LionheadGuy/bench-box-v2/wiring/bench-box-v2-poster.pdf

# BENCH BOX V2 — POWER & CONNECTIONS

The battery box for the infotainment H5: what powers what, and what plugs into what.
NOT YET BUILT OR TESTED: test each custom board on a current-limited bench supply, without the pack, before it goes in a box.

### POWER

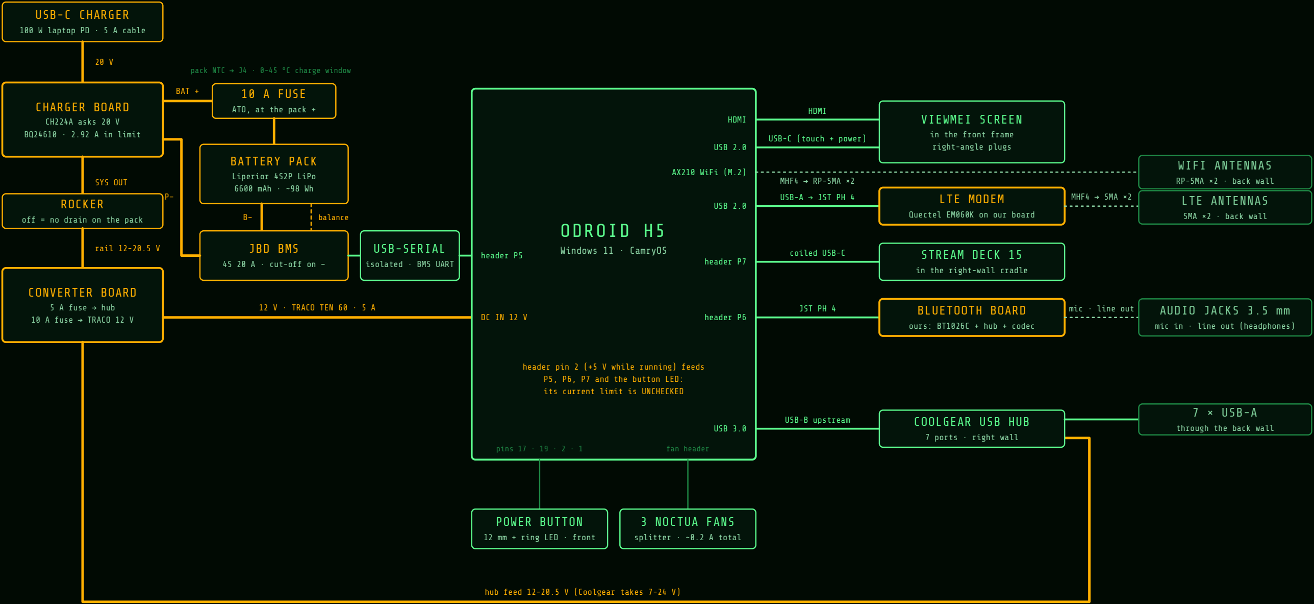
[picture p6: figure]
USB-C CHARGER; 100 W laptop PD · 5 A cable; CHARGER BOARD; CH224A asks 20 V BQ24610 · 2.92 A in limit; pack NTC → J4 · 0-45 °C charge window; BAT +; 10 A FUSE; ATO, at the pack +; BATTERY PACK; Liperior 4S2P LiPo 6600 mAh · ~98 Wh; balance; JBD BMS; 4S 20 A · cut-off on −; USB-SERIAL; isolated · BMS UART; SYS OUT ROCKER; off = no drain on the pack; rail 12-20.5 V; CONVERTER BOARD; 5 A fuse → hub 10 A fuse → TRACO 12 V; 12 V · TRACO TEN 60 · 5 A; ODROID H5; Windows 11 · CamryOS; header pin 2 (+5 V while running) feeds P5, P6, P7 and the button LED: its current limit is UNCHECKED; HDMI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

hub feed 12-20.5 V (Coolgear takes 7-24 V)

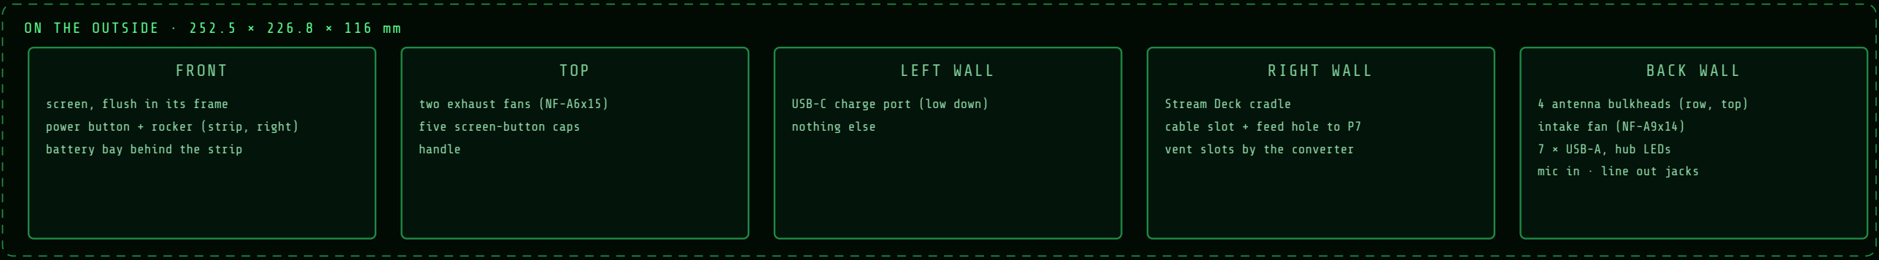
[picture p7: figure]
ON THE OUTSIDE · 252.5 × 226.8 × 116 mm; FRONT; screen, flush in its frame; power button + rocker (strip, right); battery bay behind the strip; TOP; two exhaust fans (NF-A6x15); five screen-button caps; handle; LEFT WALL; USB-C charge port (low down); nothing else; RIGHT WALL; Stream Deck cradle; cable slot + feed hole to P7; vent slots by the converter; BACK WALL; 4 antenna bulkheads (row, top); intake fan (NF-A9x14); 7 × USB-A, hub LEDs; mic in · line out jacks

power | USB / HDMI | antenna / audio lead | header pins / fan header | our own board | on the outside

Bench Box V2 · wire by wire: P.svg, D.svg, C.svg
