LionheadGuy/bench-box-v2/wiring/bench-box-v2-poster.png

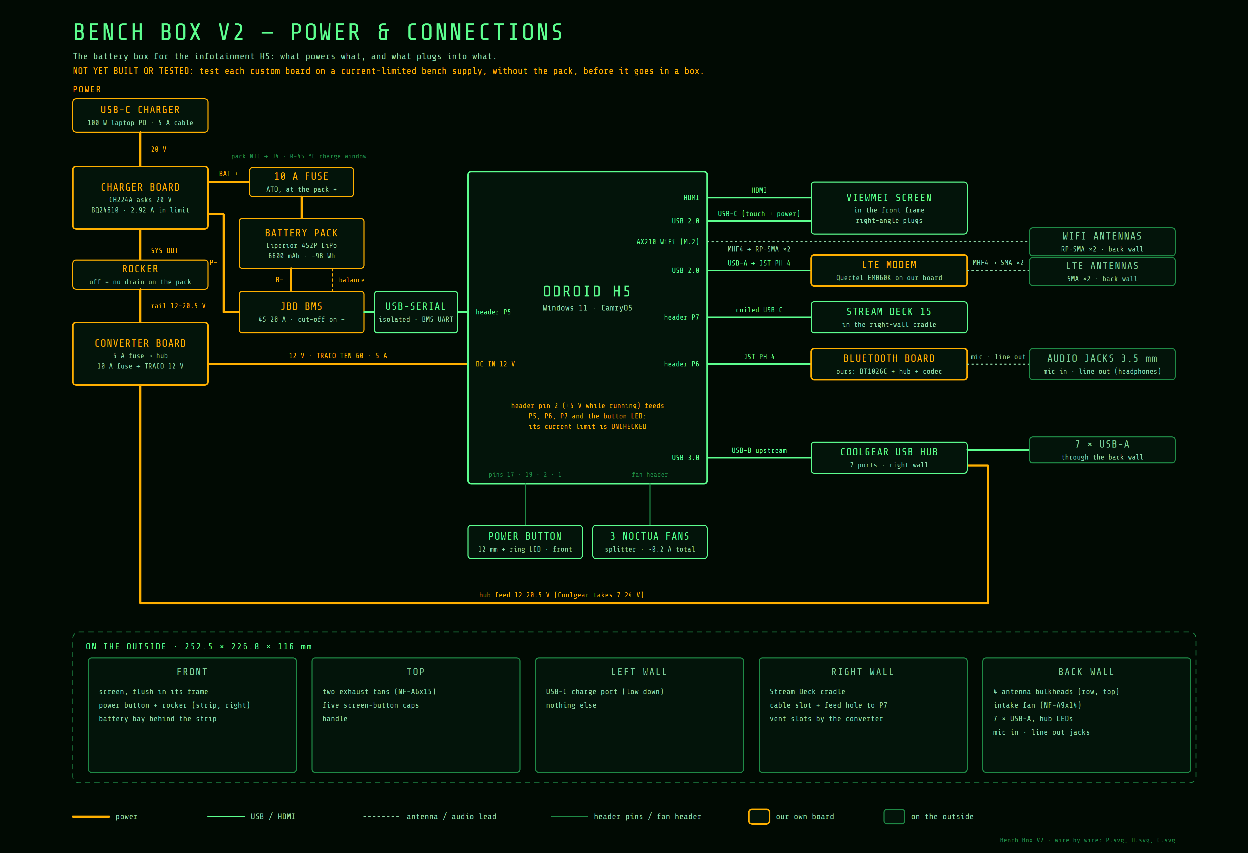
wiring/bench-box-v2-poster.png
