LionheadGuy/bench-box-v2/print/5-stream-deck-case.3mf

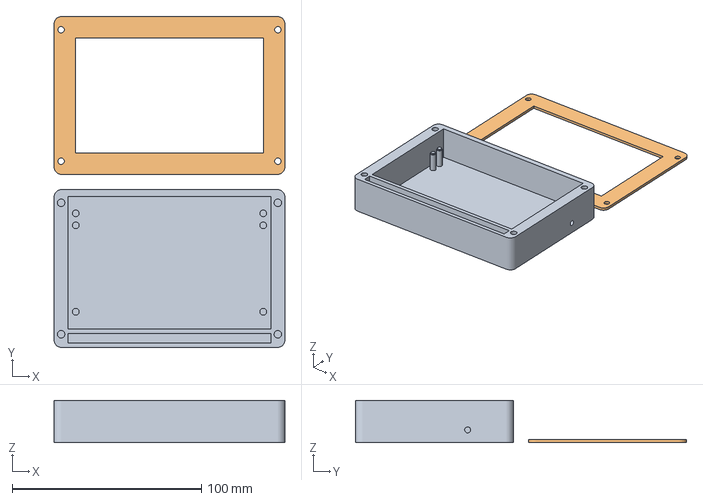
[picture p9: CAD file, 2026-11-14]
print/5-stream-deck-case.3mf
122.1 x 175.0 x 22.3 mm
sd_case_v2_tray
sd_case_v2_frame
