LionheadGuy/bench-box-v2/stl/button_cap.stl

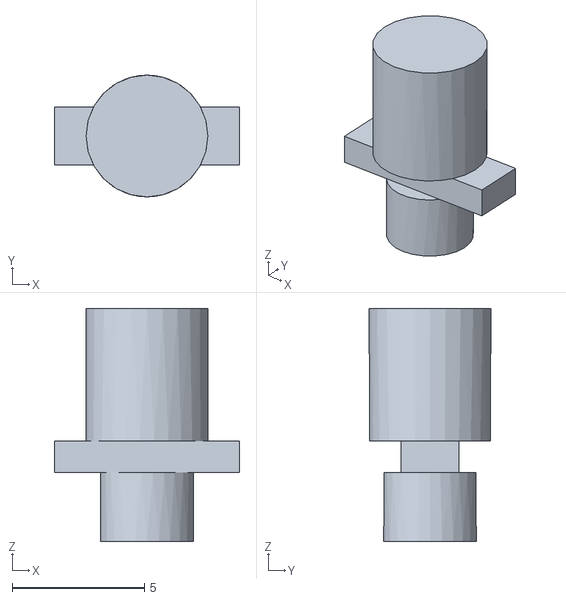
[picture p10: CAD file, 2026-11-14]
stl/button_cap.stl
7.00 x 4.60 x 8.80
