LionheadGuy/bench-box-v2/print/4-screen-button-caps.3mf

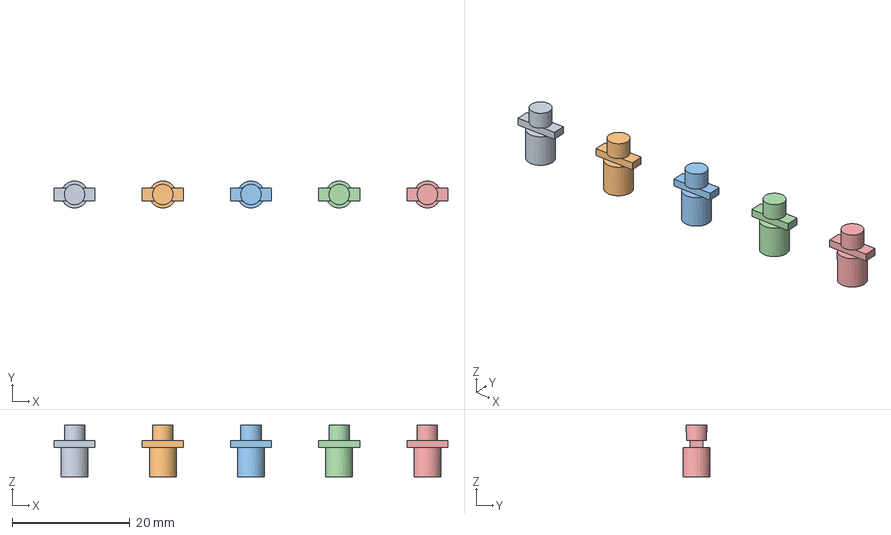
[picture p11: CAD file, 2026-11-14]
print/4-screen-button-caps.3mf
67.0 x 4.60 x 8.80 mm
button_cap_1
button_cap_2
button_cap_3
button_cap_4
button_cap_5
