LionheadGuy/bench-box-v2/stl/handle.stl

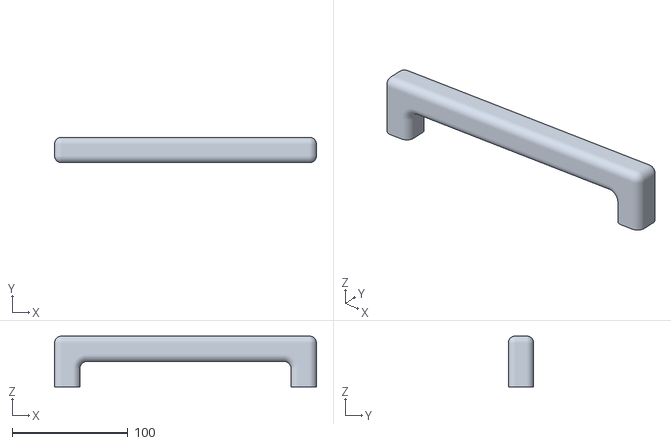
[picture p12: CAD file, 2026-11-14]
stl/handle.stl
226.5 x 22.0 x 44.0
