LionheadGuy/bench-box-v2/print/7-keystone-test.3mf

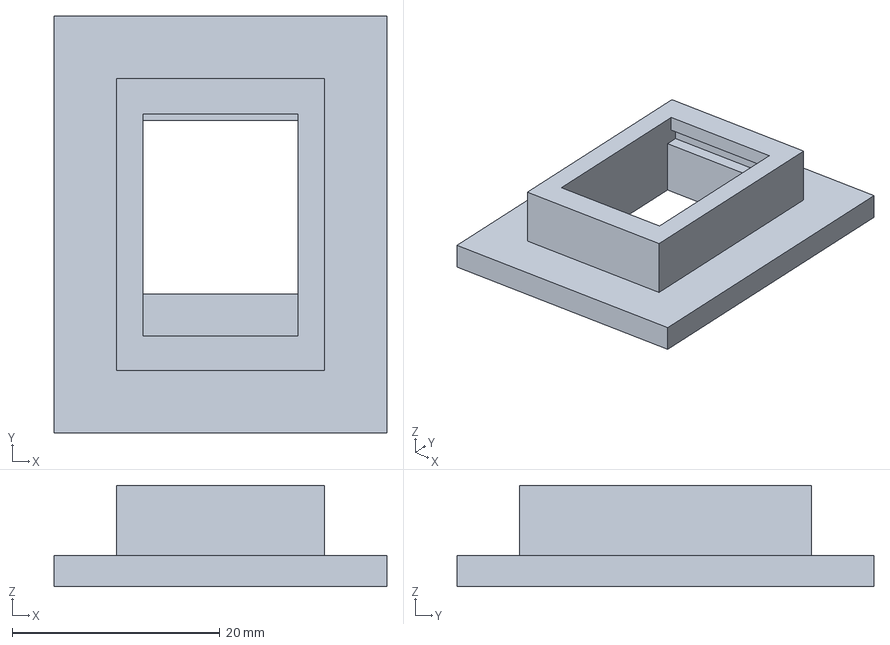
[picture p13: CAD file, 2026-11-14]
print/7-keystone-test.3mf
32.0 x 40.1 x 9.75 mm
