LionheadGuy/bench-box-v2/stl/sd_case_v2_tray.stl

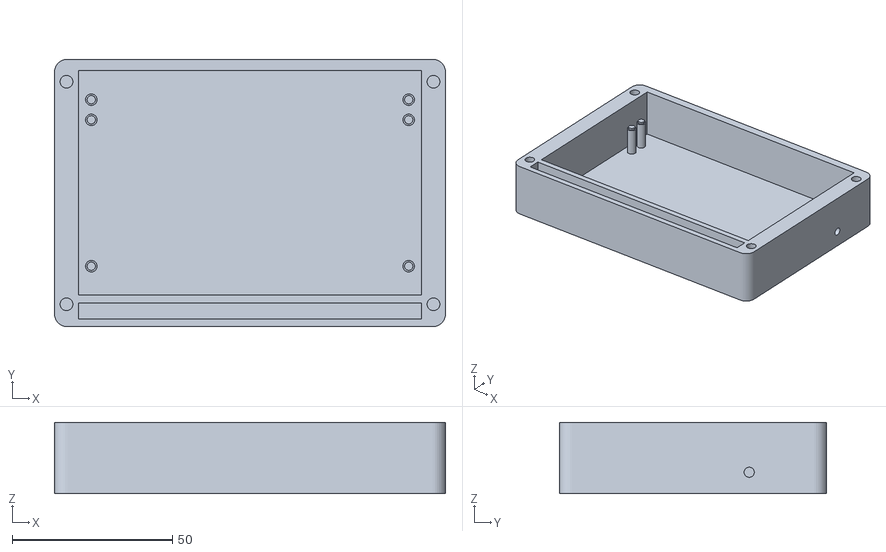
[picture p14: CAD file, 2026-11-14]
stl/sd_case_v2_tray.stl
122.1 x 83.5 x 22.3
