LionheadGuy/bench-box-v2/print/1-shell.3mf

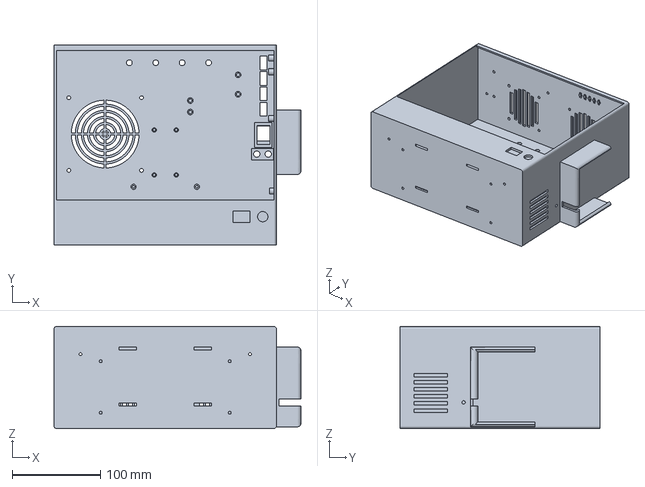
[picture p15: CAD file, 2026-11-14]
print/1-shell.3mf
280.4 x 226.8 x 116.0 mm
