LionheadGuy/bench-box-v2/print/2-front-plate.3mf

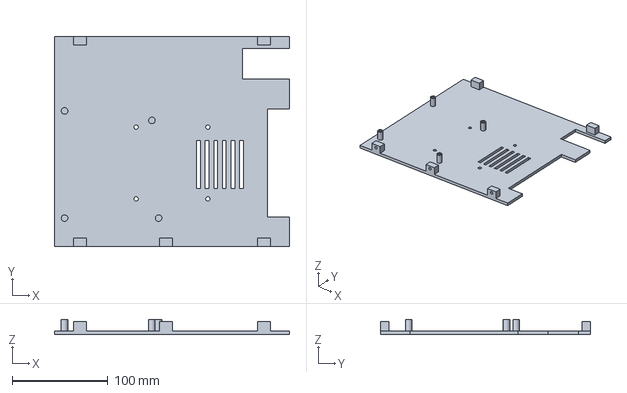
[picture p16: CAD file, 2026-11-14]
print/2-front-plate.3mf
245.9 x 220.2 x 16.0 mm
