LionheadGuy/bench-box-v2/stl/sd_case_v2_frame.stl

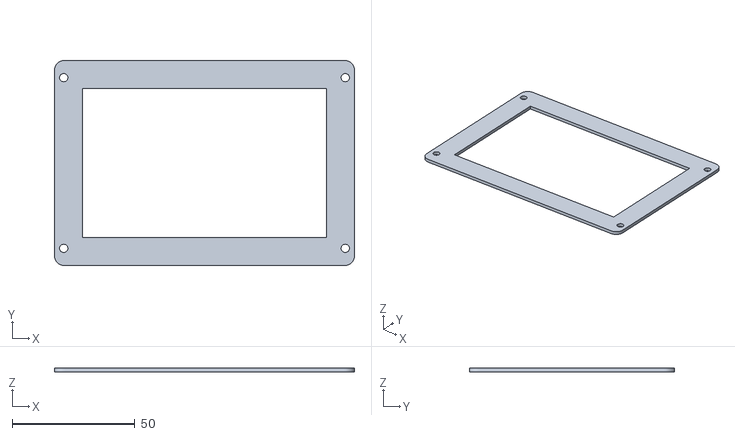
[picture p17: CAD file, 2026-11-14]
stl/sd_case_v2_frame.stl
122.1 x 83.5 x 1.60
