LionheadGuy/bench-box-v2/print/3-handle-and-feet.3mf

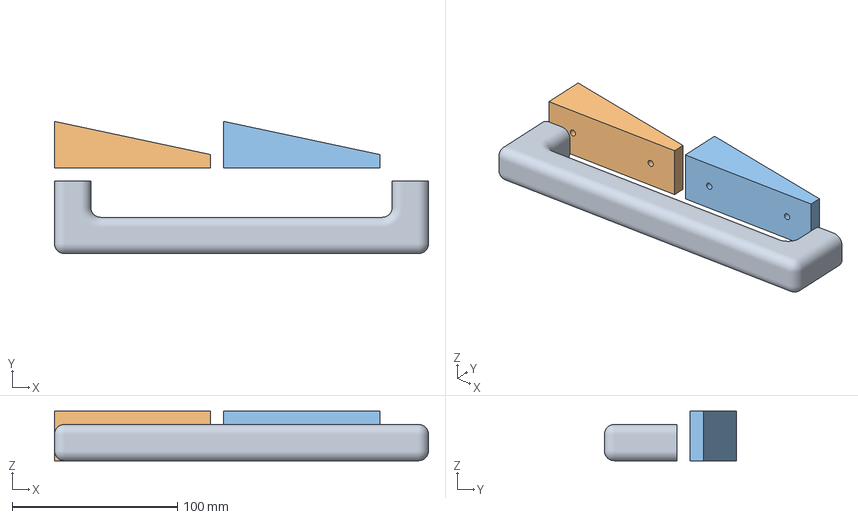
[picture p18: CAD file, 2026-11-14]
print/3-handle-and-feet.3mf
226.5 x 80.1 x 30.0 mm
handle
foot_1
foot_2
