LionheadGuy/bench-box-v2/print/6-stream-deck-cradle-test.3mf

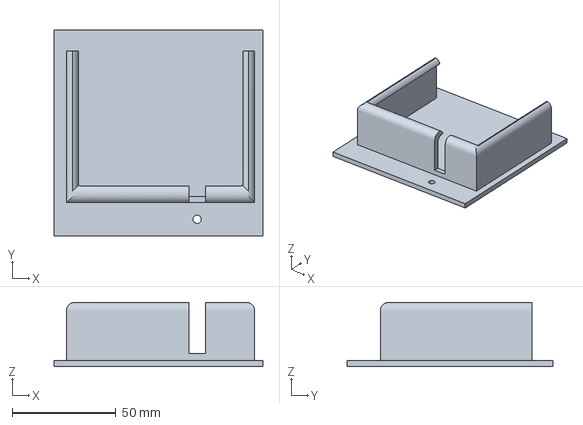
[picture p19: CAD file, 2026-11-14]
print/6-stream-deck-cradle-test.3mf
100.5 x 99.0 x 30.9 mm
