LionheadGuy/bench-box-v2/stl/foot.stl

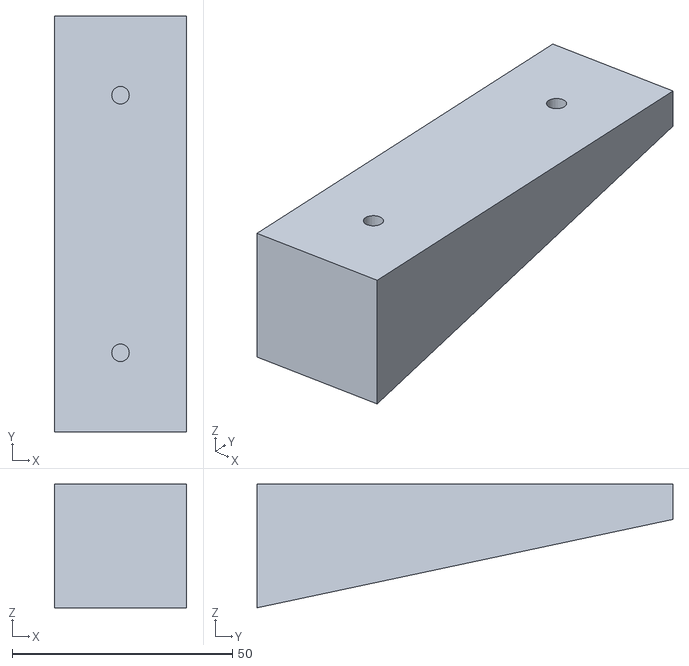
[picture p20: CAD file, 2026-11-07]
stl/foot.stl
30.0 x 94.5 x 28.1
