LionheadGuy/bench-box-v2/(list of files, cad)

Other CAD files:
stl/shell.stl
stl/keystone_test.stl
stl/sd_cradle_test.stl
stl/front_plate.stl
