LionheadGuy/bench-box-v2/wiring/index.html

# Bench box V2: rough wiring diagrams (2026-11-12)

Lengths TBD; wire count, gauges and colours PROPOSED. Wire list: wirelist.csv.

- P Power
- D Data and video
- C Controls, fans, antennas, audio

## P Power

P

## D Data and video

D

## C Controls, fans, antennas, audio

C
