LionheadGuy/bench-box-v2/(commit log)

2026-11-07 Bench Box V2: build documentation, parts list, print files and custom boards
    [1-shell.3mf, 2-front-plate.3mf, 3-handle-and-feet.3mf, 4-screen-button-caps.3mf, 5-stream-deck-case.3mf, 6-stream-deck-cradle-test.3mf, bom.csv, button_cap.stl]
2026-11-09 Optional Bluetooth hands-free board: back-wall mount, header P6, panel mic and headphone sockets; updated shell and cradle test print files
    [1-shell.3mf, 2-front-plate.3mf, 3-handle-and-feet.3mf, 4-screen-button-caps.3mf, 5-stream-deck-case.3mf, 6-stream-deck-cradle-test.3mf, bom.csv, sd_cradle_test.stl]
2026-11-10 Bluetooth board: our own 60 x 48 mm board (pcb/bluetooth) in place of the Feasycom DB200; parts, wiring and assembly updated; new shell print file
    [1-shell.3mf, 2-front-plate.3mf, 3-handle-and-feet.3mf, 4-screen-button-caps.3mf, 5-stream-deck-case.3mf, 6-stream-deck-cradle-test.3mf, bom.csv, bt-bom-pcbway.csv]
2026-11-11 Ethernet out on a Cat6 punch-down keystone jack in the back wall: new shell, BOM rows
    [1-shell.3mf, bom.csv, shell.stl]
2026-11-11 Custom boards now come from the builder (price TBD): board files removed; README describes fitting and use; LTE modem board added (coming)
    [bom.csv, bt-bom-pcbway.csv, bt-positions.csv, camry-bt-audio.kicad_sch, camry-bt-hub.kicad_sch, camry-bt-module.kicad_sch, camry-bt-serial.kicad_sch, camry-bt-usb.kicad_sch]
2026-11-11 LTE modem board: fits the Waveshare board's standoffs; assembly and wiring notes for its JST lead
    [bom.csv]
2026-11-11 Pictures: the box from the front, back and inside, and the LTE modem board (current design)
2026-11-12 Screen on the H5's USB 2.0 port, hub on the USB 3.0; Ethernet keystone jack; wiring poster and sheets; custom boards section moved after the parts list
    [bom.csv, wirelist.csv]
2026-11-12 H5 header: every lead in one 2 x 12 Dupont housing, each device on its own ground pin; wiring sheets updated
    [wirelist.csv]
2026-11-14 Refresh: the box's own hub board, the new Stream Deck case, the rounded handle
    The hub is now a board made for this box, not an off-the-shelf Coolgear: three USB-A on
    the back from a 4-port hub chip, upstream on USB-C to the computer's USB 3.0 port, a
    fourth USB-A wired straight through to a spare port on the computer, and the battery
    readout on the same board - so the USB-serial dongle and its cut extension lead are gone
    from the parts list.
    Stream Deck case: new size (122 x 83 x 24) with an even border all round and a lightened
    wall. Handle: one even section, rounded, 8 mm taller.
    Print plates rewritten from the current parts, and two fixes worth knowing about:
    - the Stream Deck tray was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
    [1-shell.3mf, 2-front-plate.3mf, 3-handle-and-feet.3mf, 4-screen-button-caps.3mf, 5-stream-deck-case.3mf, 6-stream-deck-cradle-test.3mf, 7-keystone-test.3mf, bom.csv]
